antonioasaro/3DChameleon/notes/20250202_094643.jpg

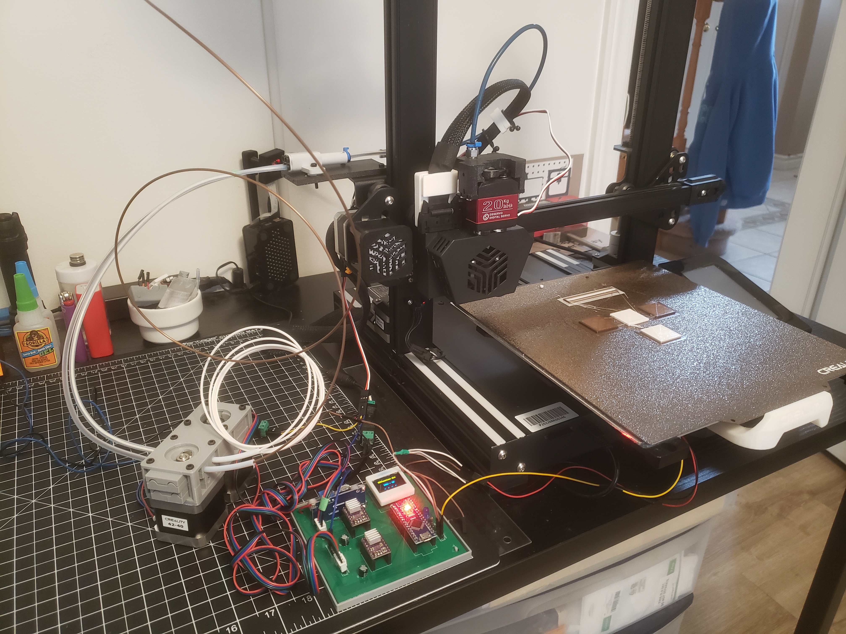
notes/20250202_094643.jpg
