antonioasaro/3DChameleon/arduino_oled_drv8825/arduino_oled_drv8825.step

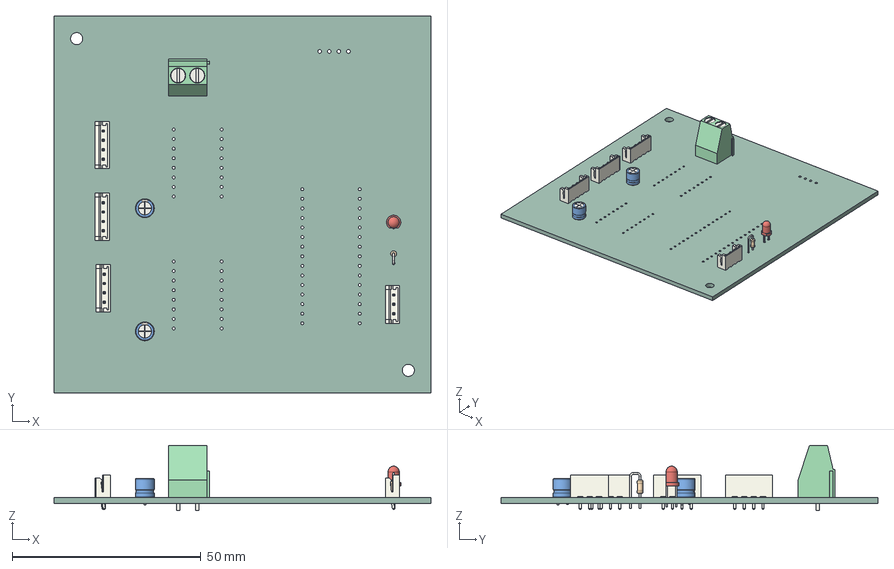
[picture p2: CAD file, 2025-02-16]
arduino_oled_drv8825/arduino_oled_drv8825.step
100.0 x 100.0 x 17.3 mm
JST_B4B_EH_A x 3
JST_B3B_EH_A
TerminalBlock_Phoenix_MKDS_15_2_508_1x02_P508mm_Horizontal
CP_Radial_D50mm_P250mm
LED_D3.0mm
CP_Radial_D50mm_P200mm
R_Axial_DIN0204_L36mm_D16mm_P254mm_Vertical
arduino_oled_drv8825_PCB
