antonioasaro/3DChameleon/STL/Sailfin Blade Holder.stl

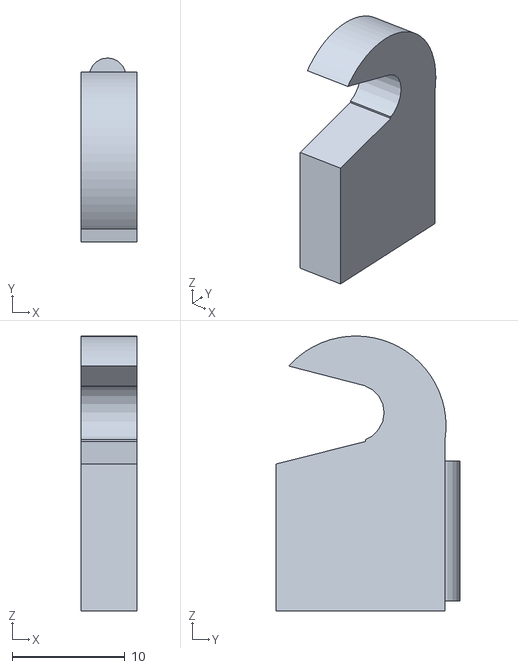
[picture p3: CAD file, 2025-02-17]
STL/Sailfin Blade Holder.stl
5.00 x 16.3 x 24.4
