antonioasaro/3DChameleon/STL/3DClippy_modified_base.stl

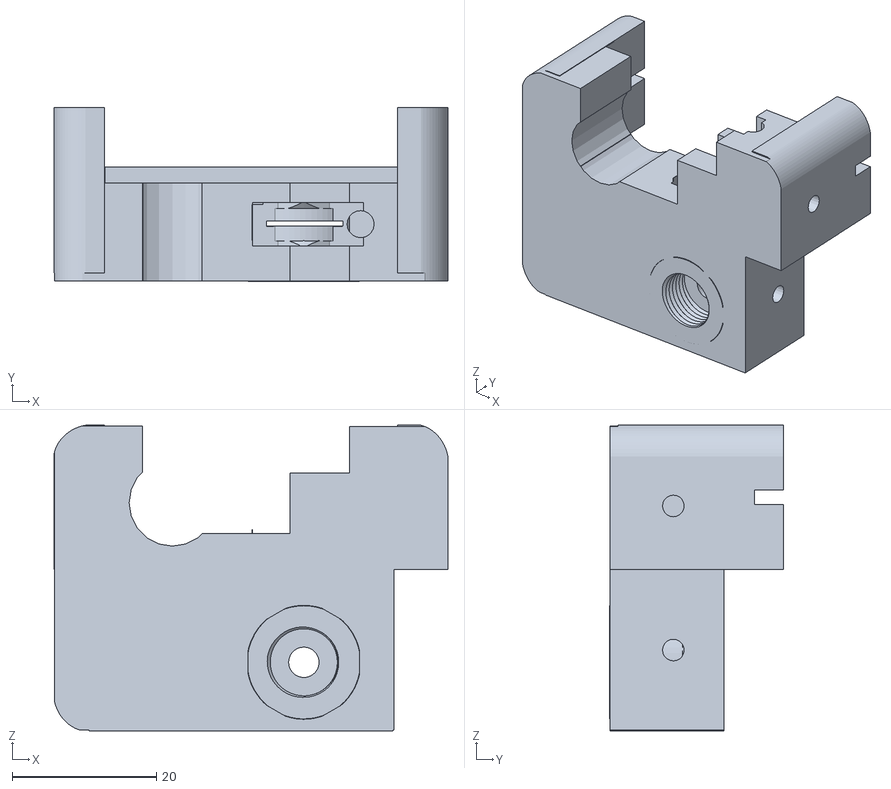
[picture p4: CAD file, 2025-02-17]
STL/3DClippy_modified_base.stl
54.7 x 24.1 x 42.4
