antonioasaro/3DChameleon/STL/3DClippy_stand-top.stl

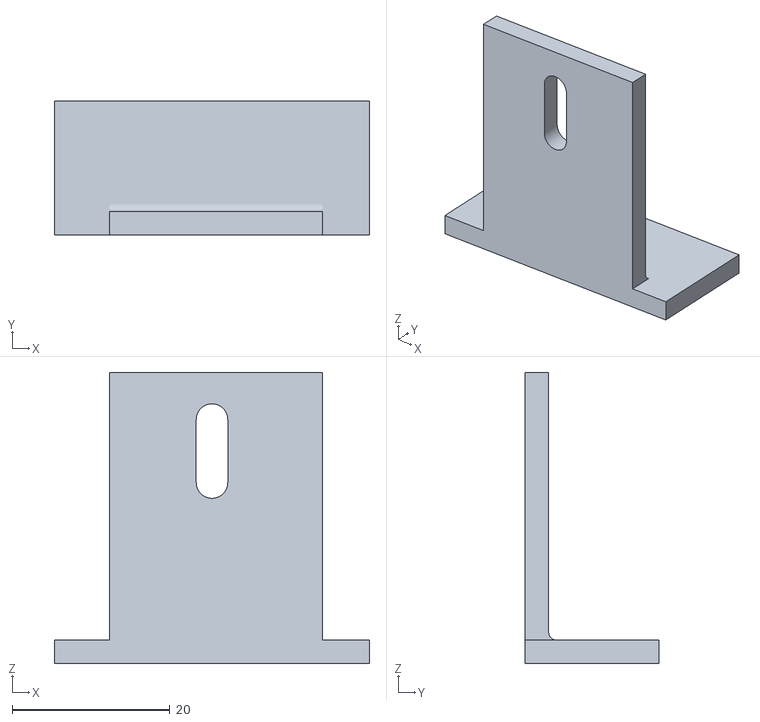
[picture p5: CAD file, 2025-02-17]
STL/3DClippy_stand-top.stl
40.0 x 17.0 x 37.0
