antonioasaro/3DChameleon/STL/3DClippy_stand-base.stl

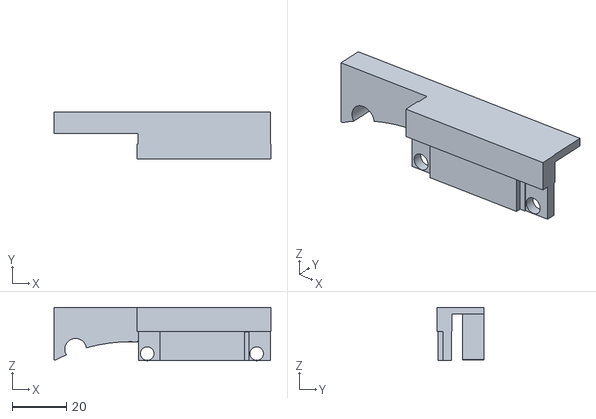
[picture p6: CAD file, 2025-02-17]
STL/3DClippy_stand-base.stl
80.3 x 17.4 x 19.7
