antonioasaro/3DChameleon/arduino_oled_drv8825/arduino_oled_drv8825.kicad_pcb

## KiCad design arduino_oled_drv8825/arduino_oled_drv8825.kicad_pcb (2025-02-16)

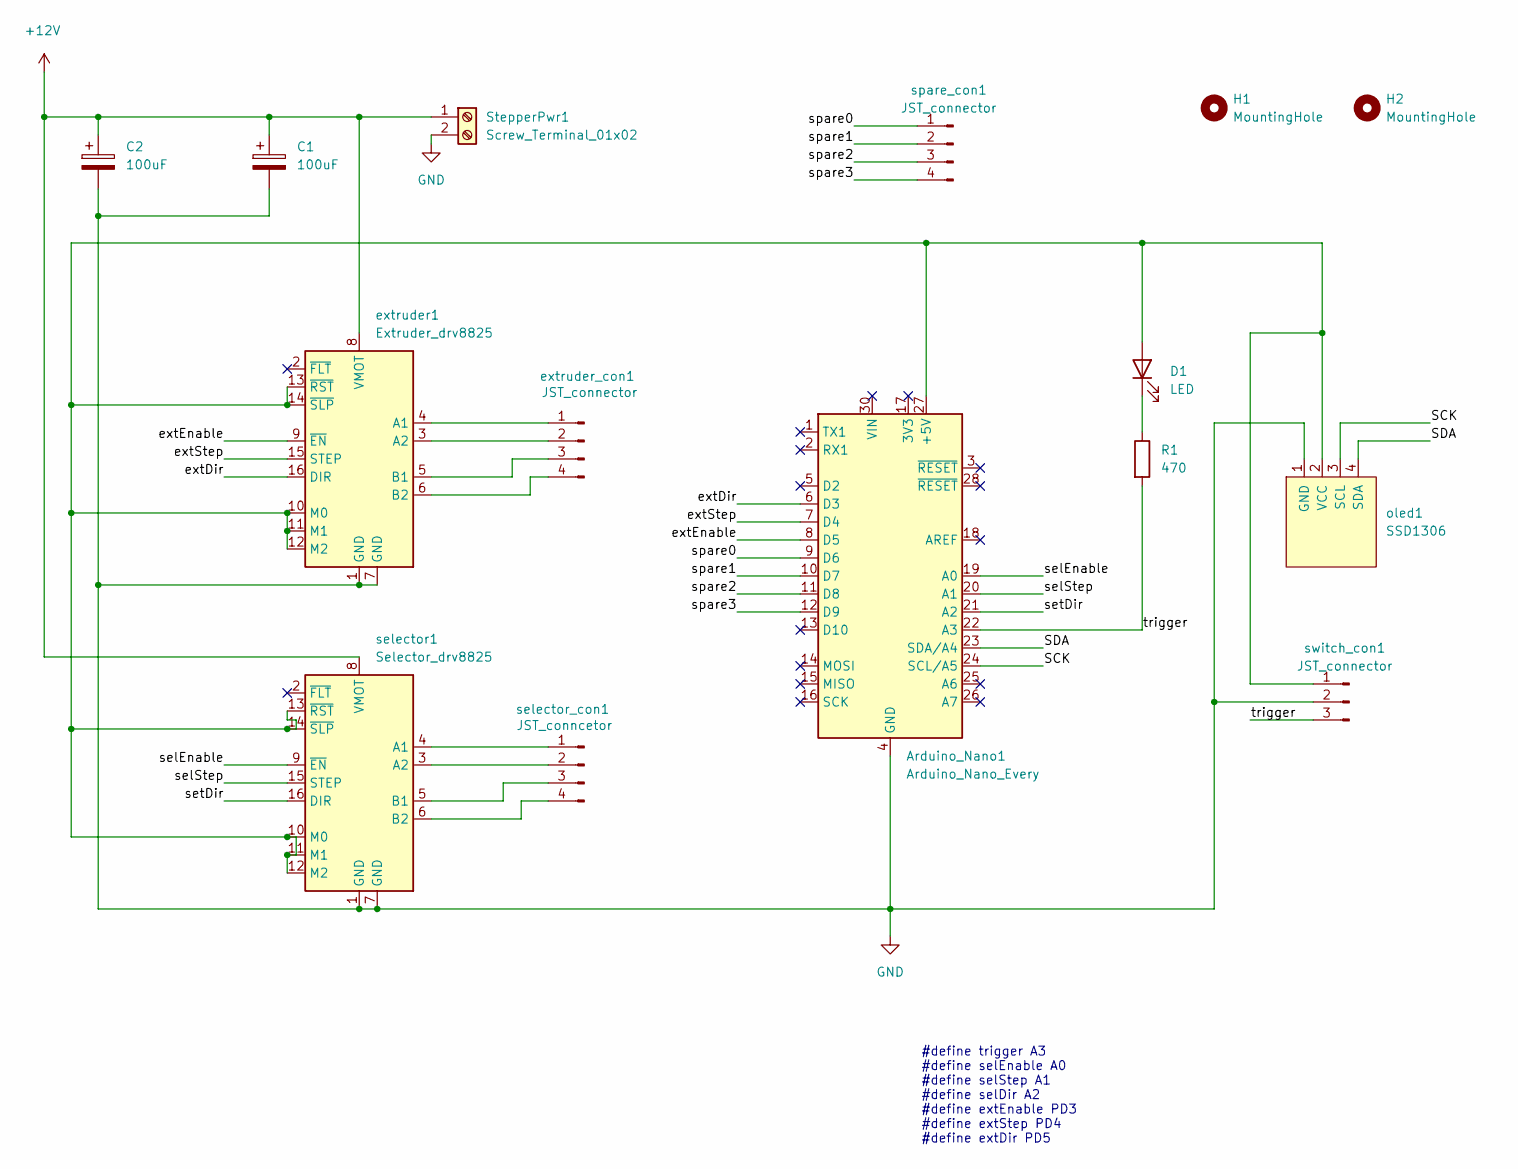
[picture p7: schematic arduino_oled_drv8825.kicad_sch]

Parts:
Arduino_Nano1: Arduino_Nano_Every
C1: 100uF; CP_Radial_D5.0mm_P2.50mm
C2: 100uF; CP_Radial_D5.0mm_P2.00mm
D1: LED; LED_D3.0mm
H1, H2: MountingHole; MountingHole_3.2mm_M3
R1: 470; R_Axial_DIN0204_L3.6mm_D1.6mm_P2.54mm_Vertical
StepperPwr1: Screw_Terminal_01x02; TerminalBlock_Phoenix_MKDS-1,5-2-5.08_1x02_P5.08mm_Horizont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
extruder1: Extruder_drv8825; Pololu_Breakout-16_15.2x20.3mm
extruder_con1: JST_connector; JST_EH_B4B-EH-A_1x04_P2.50mm_Vertical
oled1: SSD1306; 128x64OLED
selector1: Selector_drv8825; Pololu_Breakout-16_15.2x20.3mm
selector_con1: JST_conncetor; JST_EH_B4B-EH-A_1x04_P2.50mm_Vertical
spare_con1: JST_connector; JST_EH_B4B-EH-A_1x04_P2.50mm_Vertical
switch_con1: JST_connector; JST_EH_B3B-EH-A_1x03_P2.50mm_Vertical

Connections:
+12V: C1.1, C2.1, StepperPwr1.1, extruder1.8 (VMOT), selector1.8 (VMOT)
/SCK: Arduino_Nano1.24 (SCL/A5), oled1.3 (SCL)
/SDA: Arduino_Nano1.23 (SDA/A4), oled1.4 (SDA)
/extDir: Arduino_Nano1.6 (D3), extruder1.16 (DIR)
/extEnable: Arduino_Nano1.8 (D5), extruder1.9 (~EN)
/extStep: Arduino_Nano1.7 (D4), extruder1.15 (STEP)
/selEnable: Arduino_Nano1.19 (A0), selector1.9 (~EN)
/selStep: Arduino_Nano1.20 (A1), selector1.15 (STEP)
/setDir: Arduino_Nano1.21 (A2), selector1.16 (DIR)
/spare0: Arduino_Nano1.9 (D6), spare_con1.1
/spare1: Arduino_Nano1.10 (D7), spare_con1.2
/spare2: Arduino_Nano1.11 (D8), spare_con1.3
/spare3: Arduino_Nano1.12 (D9), spare_con1.4
/trigger: Arduino_Nano1.22 (A3), R1.2, switch_con1.3
GND: Arduino_Nano1.4 (GND), Arduino_Nano1.29 (GND), C1.2, C2.2, StepperPwr1.2, extruder1.1 (GND), extruder1.7 (GND), oled1.1 (GND), selector1.1 (GND), selector1.7 (GND), switch_con1.2
unnamed: Arduino_Nano1.27 (+5V), D1.2 (A), extruder1.10 (M0), extruder1.11 (M1), extruder1.12 (M2), extruder1.13 (~RST), extruder1.14 (~SLP), oled1.2 (VCC), selector1.10 (M0), selector1.11 (M1), selector1.12 (M2), selector1.13 (~RST), selector1.14 (~SLP), switch_con1.1
unnamed: D1.1 (K), R1.1
unnamed: extruder1.4 (A1), extruder_con1.1
unnamed: extruder1.3 (A2), extruder_con1.2
unnamed: extruder1.5 (B1), extruder_con1.3
unnamed: extruder1.6 (B2), extruder_con1.4
unnamed: selector1.4 (A1), selector_con1.1
unnamed: selector1.3 (A2), selector_con1.2
unnamed: selector1.5 (B1), selector_con1.3
unnamed: selector1.6 (B2), selector_con1.4

Notes on the sheet:
#define trigger A3 #define selEnable A0 #define selStep A1 #define selDir A2 #define extEnable PD3 #define extStep PD4 #define extDir PD5

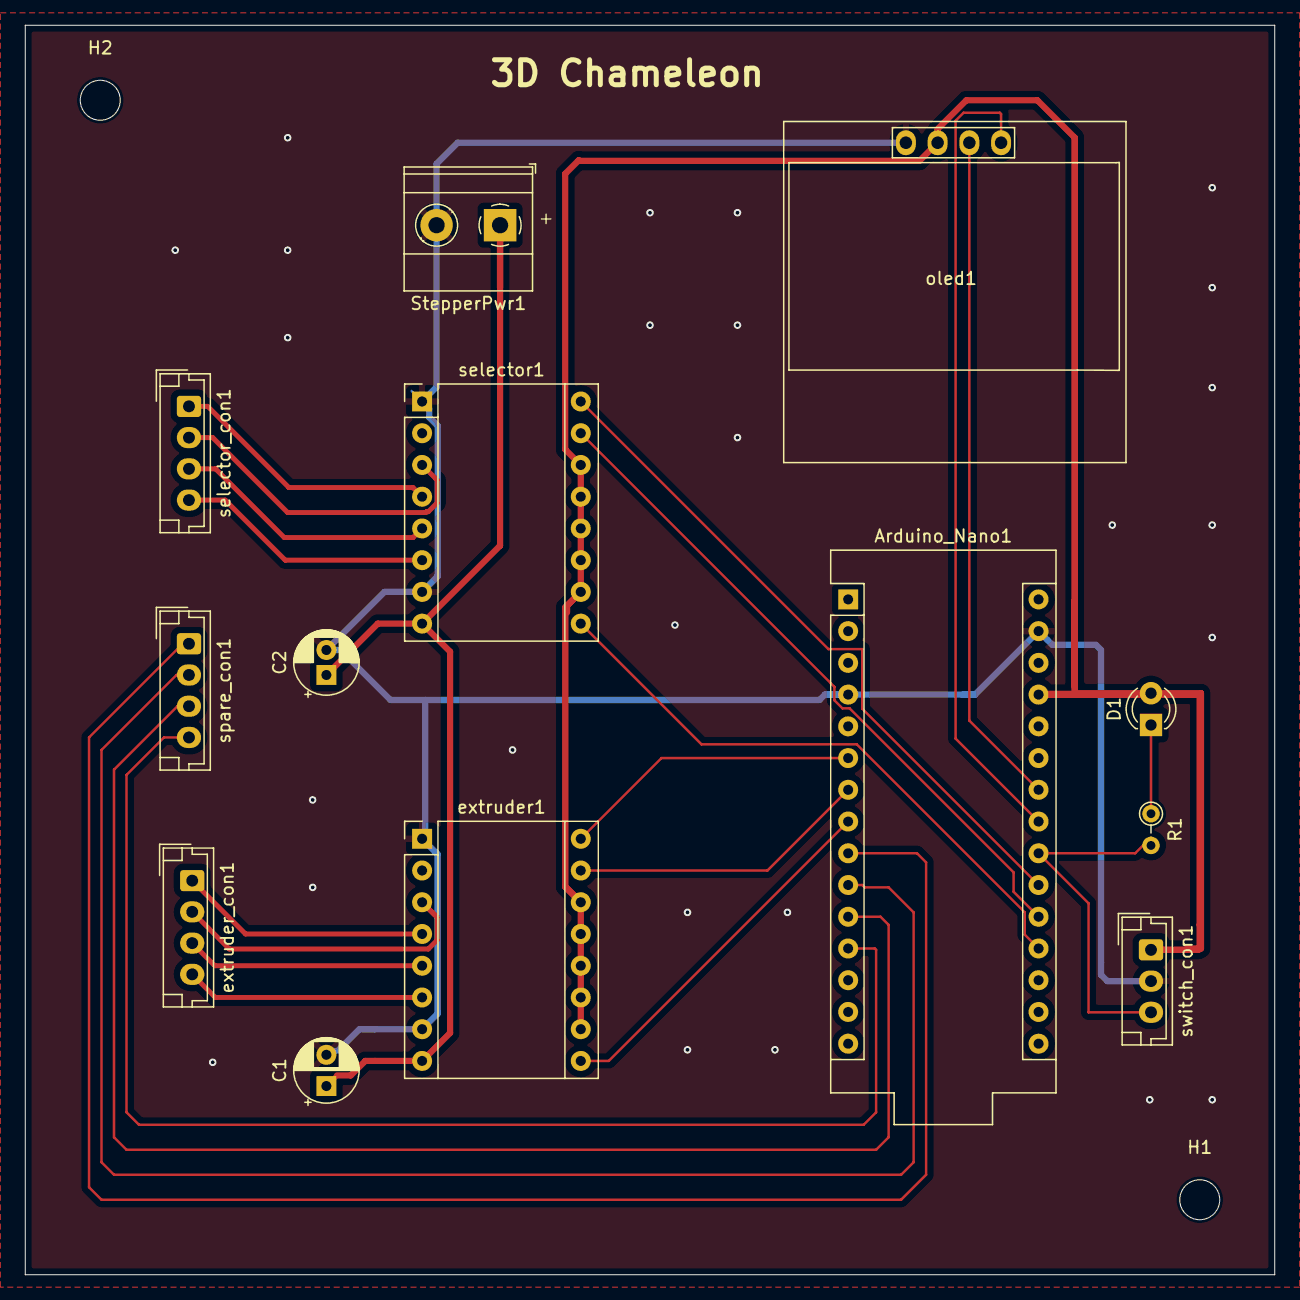
[picture p8: board arduino_oled_drv8825.kicad_pcb from above]

Board: 2 copper layers, 100.0 x 100.0 mm, 15 parts (0 on the bottom side), 25 nets.
