antonioasaro/3DChameleon/notes/CHAMELEON.cfg

[gcode_macro CHAMELEON_START]
gcode:
	G90
	M83
	G92 E0
	G0 X0 Y232 F2000   ; move close to button
	G4 P150            ; wait 150ms
	G0 X0 Y235 F2000   ; press the button 1st time
	G4 P150            ; wait 150ms
	G0 X0 Y232 F2000   ; move close to button
	G4 P150            ; wait 150ms
	G0 X0 Y235 F2000   ; press the button 2st time
	G4 P150            ; wait 150ms
	G0 X0 Y232 F2000   ; move close to button
	G4 P150            ; wait 150ms
	G0 X0 Y235 F2000   ; press the button 3st time
	G4 P150            ; wait 150ms
	G0 X0 Y232 F2000   ; move close to button
	G4 P1000           ; wait 1 second
	G0 X0 Y235 F2000   ; press the button
	G4 P3600           ; wait 7 pulses
	G0 X0 Y232 F2000   ; move away from button
	G4 P2000           ; wait 2 seconds

[gcode_macro CHAMELEON_CUT]
gcode:
	G0 E5 F500
	G0 E-110 F1000
	G0 Y3 F2000
	G4 P5100 ; wait 10 pulses
	G0 Y-3 F2000
	G4 P5000
	G0 E20 F1000
	G0 E-40 F2000
	
[gcode_macro CHAMELEON_EXTRUDE]
gcode:
	G0 Y3 F2000
	G4 P9000
	G0 E25 F1500; <<<--- adjust this E value to tune extruder loading
	G0 Y-3
	G4 P400

[gcode_macro CHAMELEON_EXTRUDE_HOTEND]
gcode:
	G92 E0
	G0 E100 F1000
	G92 E0
	G0 E100 F1000
	G92 E0
	G0 E100 F1000
	G92 E0
	G0 E100 F1000
	G92 E0
	G0 E30 F1000
	G92 E0
	G0 E30 F800 ; <<<<<-----------  EDIT THIS DISTANCE TO FINE TUNE THE FILAMENT LOADING TO STOP BLOBBING OR UNDEREXTRUSION
	G92 E0

[gcode_macro CHAMELEON_RETRACT_HOTEND]
gcode:
	G92 E0
	G0 E-100 F1000
	G92 E0
	G0 E-100 F1000
	G92 E0
	G0 E-100 F1000
	G92 E0
	G0 E-100 F1000
	G92 E0
	G0 E-40 F1000
	G92 E0

[gcode_macro CHAMELEON_RETRACT]
gcode:
	G0 Y3 F2000
	G4 P9000
	G4 P250
	G0 Y-3
	G4 P400

[gcode_macro CHAMELEON_HOMEUNLOAD]
gcode:
	G90                    	; absolute XYZE
	G0 Y232 F2000
	G4 P2000
	G91 					; relative XYZE
	G0 Y3 F2000
	G4 P3100 				; wait 6 pulses
	G0 Y-3 F2000
	G4 P2000


	
