antonioasaro/3DChameleon/SelectorFirmwareMk4/SelectorFirmwareMk4.ino

// November 28, 2024

/* 3DChameleon Mk4.1 Firmware

Copyright 2024 William J. Steele

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
Single Button Press Commands (count pulses of selector)

#1 - 1
#2 - 2
#3 - 3
#4 - 4
#5 - Home and Load
#6 - Unload Last and Home
#7 - Home
#8 - Next Filament
#9 - Random Filament
#10 - Cut
 
*/

#include <SSD1306Ascii.h> //i2C OLED
#include <SSD1306AsciiWire.h> //i2C OLED
#include <SparkFunSX1509.h> // sparkfun i/o expansion board - used for additional filament sensors as well as communications with secondary boards
#include <Wire.h>
#include <SPI.h>
#include <Servo.h>

#define ANTONIO
#define SCREEN_WIDTH 128 // OLED display width, in pixels
#define SCREEN_HEIGHT 64 // OLED display height, in pixels

/**
 * Made with Marlin Bitmap Converter
 * https://marlinfw.org/tools/u8glib/converter.html
 *
 * This bitmap from 128x64 pasted image
 */
#pragma once

const unsigned char bitmap_logo[] PROGMEM = {
  B00000000,B00000000,B00000000,B00000000,B00000000,B00000000,B00000000,B00000000,B00000000,B00000000,B00000000,B00000000,B00000000,B00000000,B00000000,B00000000,
  B00000000,B00000000,B00000000,B00000000,B00000000,B00000000,B00000000,B00000000,B00000000,B00000000,B00000000,B00000000,B00000000,B00000000,B00000000,B00000000,
  B00000000,B00000000,B00000000,B00000000,B00000000,B00000000,B00000000,B00000000,B00000000,B00000000,B00000000,B00000000,B00000000,B00000000,B00000000,B00000000,
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

const int defaultBackoff = 10;

Servo filamentCutter;  // create servo object to control a servo
int cutterPos = 0;    // variable to store the servo position
bool reverseServo = true;

int currentExtruder = -1;
int nextExtruder = 0;
int lastExtruder = -1;
int tempExtruder = -1;

int seenCommand = 0;
int prevCommand = 0;

int loaderMode = 2;  //(0= direct drive, 1=loader/unloader, 2=loader/unloader with press)

long triggerTime = 300;
long pulseTime = (triggerTime / 2);

long distance = 10;

long unloadDistance = stepsPerRev * microSteps * distance;  // this is 10 revs - about 10"
long loadDistance   = unloadDistance * 1.1;           // this is 11 revs - about 11"

int address = 0;
byte value;

long idleCount = 0;
bool logoActive = false;
bool T0Loaded = false;
bool T1Loaded = false;
bool T2Loaded = false;
bool T3Loaded = false;


bool displayEnabled = false;
bool ioEnabled = false;
//int sensorEnabled = 0;

long randomNumber = 0;

void setup()
{

#ifdef ANTONIO
  Serial.begin(115200);
  delay(1000);
  Serial.println("\nSetup ...");
#endif 

  Wire.begin(); //start i2C  
	Wire.setClock(400000L); //set clock

  // set up IO expander
  if (io.begin(SX1509_ADDRESS) == true)
  {
    io.pinMode(SX1509_FILAMENT_0, INPUT_PULLUP);
    io.pinMode(SX1509_FILAMENT_1, INPUT_PULLUP);
    io.pinMode(SX1509_FILAMENT_2, INPUT_PULLUP);
    io.pinMode(SX1509_FILAMENT_3, INPUT_PULLUP);
    io.pinMode(SX1509_OUTPUT, OUTPUT);
    ioEnabled = true;
  }

  // enable OLED display
  oled.begin(&Adafruit128x64, OLED_I2C_ADDRESS);

  // wait for it to start up
  delay(50);
    

  // welcome screen
  oled.setFont(Adafruit5x7);
  oled.clear(); //clear display
	oled.println("");
  oled.println("       Welcome!"); //print a welcome message  
  oled.println("");
  oled.println("    3DChameleon Mk4"); //print a welcome message
  oled.println("");
  oled.println("      Pro - v1.4");
  delay(3000);

  displayText(0, "       Ready!");
  
  seenCommand = 0;

  // Sets the two pins as Outputs
  pinMode(extEnable, OUTPUT);
  pinMode(extStep, OUTPUT);
  pinMode(extDir, OUTPUT);

  pinMode(selEnable, OUTPUT);
  pinMode(selStep, OUTPUT);
  pinMode(selDir, OUTPUT);

  // set up the button
  pinMode(trigger, INPUT_PULLUP);  // selector

  // a little override here... we're using the two inputs as I2C instead
  pinMode(s_limit, OUTPUT);    
  pinMode(filament, OUTPUT); 

  // lock the selector by energizing it
  digitalWrite(selEnable, HIGH);

  // make sure filament isn't blocked by gillotine
  connectGillotine();
 #ifdef ANTONIO
  openServo();
 #else 
  cutFilament();
 #endif 
  disconnectGillotine();
  
  prevCommand = 0;

#ifdef ANTONIO
  Serial.println("Done.");
#endif

}

int lastLoop = 0;

void loop()
{
  static uint32_t lastTime = 0;

  seenCommand = 0;
  idleCount++;

  // process button press
  if (digitalRead(trigger) == 0)
  {
    idleCount = 0;
    logoActive = false;
    unsigned long nextPulse;
    unsigned long pulseCount = 0;
    unsigned long commandCount = 0;

    // keep counting (and pulsing) until button is released
    while (digitalRead(trigger) == 0)
    {
      if(pulseCount<pulseTime)
      {
        pulseCount++;
        displayCommand(pulseCount);
        if(pulseCount>1) vibrateMotor();
      }
      delay(400);  // each pulse is 400+ milliseconds apart 
    }
    processCommand(pulseCount); // ok... execute whatever command was caught (by pulse count)
    pulseCount = 0;
  }

  // updates IO block, duh!  No really, grabs the state of the sparkfun gpio expansion
  updateIOBlock();

  // each loop adds 50ms delay, so that gets added AFTER the command is processed before the next one can start
  delay(50);
}

// read the sparkfun SX1509 io
void updateIOBlock()
{
    if(ioEnabled)
    {
      T0Loaded = io.digitalRead(SX1509_FILAMENT_0);
      T1Loaded = io.digitalRead(SX1509_FILAMENT_1);
      T2Loaded = io.digitalRead(SX1509_FILAMENT_2);
      T3Loaded = io.digitalRead(SX1509_FILAMENT_3);
    }
}

// display command for each button pulse
void displayCommand(long commandCount)
{

  switch(commandCount)
  {
  case 2:
    displayText(25, "    Switch to T0");
    break;
  case 3:
    displayText(25, "    Switch to T1");
    break;
  case 4:
    displayText(25, "    Switch to T2");
    break;
  case 5:
    displayText(25, "    Switch to T3");
    break;
  case 6:
    displayText(25, "    Home/Load T0");
    break;
  case 7:
    displayText(28, "    Unload/Home");
    break;
  case 8:
    displayText(50, "        Home");
    break;  
  case 9:
    displayText(50, "        Next");
    break;
  case 10:
    displayText(40, "       Random");
    break;
#ifdef ANTONIO   
  case 11:
    displayText(50, "       Cut ");
    break;  
#endif
  default:
    displayText(30, "     No Command");
    break;
  }
}

// execute the pulse count command
void processCommand(long commandCount)
{

  // select case for commands
  switch (commandCount)
  {
  case 2: // unload current, switch to #0, load
    displayText(30, "     T0 Selected");
    currentExtruder = 0;
    processMoves();
    displayText(35, "      Idle - T0");
    break;

  case 3: // unload current, switch to #1, load
    displayText(30, "     T1 Selected");
    currentExtruder = 1;
    processMoves();
    displayText(35, "      Idle - T1");
    break;

  case 4: // unload current, switch to #3, load
    displayText(30, "     T2 Selected");
    currentExtruder = 2;
    processMoves();
    displayText(35, "      Idle - T2");
    break;

  case 5: // unload current, switch to #4, load
    displayText(30, "     T3 Selected");
    currentExtruder = 3;
    processMoves();
    displayText(35, "      Idle - T3");
    break;

  case 6: //home and reload #1
    displayText(40, "      Homing...");
    homeSelector();
    displayText(15, "   Press to Load T0");
    gotoExtruder(0, 0);
    if(loaderMode>0)rotateExtruder(clockwise, loadDistance);
    if(loaderMode>0)gotoExtruder(0, 1);
    currentExtruder = 0;
    lastExtruder = 0;
    displayText(35, "      Idle - T0");
    break;
    
  case 7: // unload current and rehome selector
    displayText(30, "     Cutting...");
    connectGillotine();
    cutFilament();
    switch(lastExtruder)
    {
      case 0:
        displayText(10, "  Press to Unload T0");
        break;
      case 1:
        displayText(10, "  Press to Unload T1");
        break;
      case 2:
        displayText(10, "  Press to Unload T2");
        break;
      case 3:
        displayText(10, "  Press to Unload T3");
        break;
    } 
    if(loaderMode>0)gotoExtruder((lastExtruder==3?2:lastExtruder+1),lastExtruder);
    if(lastExtruder<2)
    {
      if(loaderMode>0)rotateExtruder(counterclockwise, unloadDistance);
    }
    else
    {
      if(loaderMode>0)rotateExtruder(clockwise, unloadDistance);
    }
    disconnectGillotine();
    displayText(50, "        Idle");
    break;

  case 8:  
    displayText(40, "     Homing...");
    homeSelector();
    displayText(50, "        Idle");
    break;

  case 9: // move to next available filament
    displayText(30, "     Cutting...");
    connectGillotine();
    cutFilament();
    displayText(30, "     Next Tool");
    currentExtruder++;
    if(currentExtruder==4)currentExtruder=0;
    processMoves();
    displayText(35, "        Idle");
    break;

  case 10: // move to a random filament
    displayText(30, "     Cutting...");
    connectGillotine();
    cutFilament();
    displayText(30, "    Random Tool");

    // select a random number
    randomNumber = random(0,2) + 1;

    // skip ahead that many tools
    for(long i=0; i<randomNumber; i++)
    {
      currentExtruder++;
      if(currentExtruder==4)currentExtruder=0;
    }
    processMoves();
    displayText(50, "        Idle");
    break;
#ifdef ANTONIO  
  case 11: // cut filament
    displayText(30, "     Cutting...");
    connectGillotine();
    cutServo();
    cutServo();
    disconnectGillotine();
    displayText(50, "        Idle");
    break;
 #endif  
    
  default:
    displayText(47, "       Clear");
    delay(200);

    displayText(50, "        Idle");
    break;
  }
}

// just the routine to update the OLED
void displayText(int offset, String str)
{

  //if(displayEnabled){
    oled.clear();
    oled.println("");
    oled.println("   3DChameleon Mk4"); //print a welcome message
    oled.println("");
    oled.println("");
    oled.println(str);
    oled.println("");
    oled.println("");
    if(ioEnabled)
    {
      oled.print("     ");
      if(T0Loaded)
      {
        oled.print("0  ");
      }
      else
      {
        oled.print("+  ");
      }
      if(T1Loaded)
      {
        oled.print("1  ");
      }
      else
      {
        oled.print("+  ");
      }
      if(T2Loaded)
      {
        oled.print("2  ");
      }
      else
      {
        oled.print("+  ");
      }
      if(T3Loaded)
      {
        oled.println("3");
      }
      else
      {
        oled.println("+");
      }
    }
    else
    {
      oled.println("     -  -  -  -");
    }
  //  }
}

// real work is here
void processMoves()
{

  // make sure we have a real extruder selected
  if(lastExtruder>-1)
  {

    // if so, we need to cut the filament
    displayText(30, "     Cutting...");
    connectGillotine();
    cutFilament();

    // ok... then wait for the 2nd button press to unload it
    switch(lastExtruder)
    {
      case 0:
        displayText(10, "  Press to Unload T0");
        break;
      case 1:
        displayText(10, "  Press to Unload T1");
        break;
      case 2:
        displayText(10, "  Press to Unload T2");
        break;
      case 3:
        displayText(10, "  Press to Unload T3");
        break;
    } 

    // roll over to first if on last
    if( loaderMode>0 ) gotoExtruder( ( lastExtruder==3 ? 2 : (lastExtruder+1)), lastExtruder);

    // this determines which direction to move the motor, 0-1 : counterclockwise, 2-3 : clockwise
    if(lastExtruder<2)
    {
      if(loaderMode>0)rotateExtruder(counterclockwise, unloadDistance);
    }
    else
    {
      if(loaderMode>0)rotateExtruder(clockwise, unloadDistance);
    }
  }
  else
  {
    lastExtruder = 0;
  }
  disconnectGillotine();
  
  // tell it to actually execute that command now
  gotoExtruder(lastExtruder, currentExtruder);

  // ok... filament unloaded, time to load the new... so tell the user
  switch(currentExtruder)
  {
    case 0:
      displayText(15, "   Press to Load T0");
      break;
    case 1:
      displayText(15, "   Press to Load T1");
      break;
    case 2:
      displayText(15, "   Press to Load T2");
      break;
    case 3:
      displayText(15, "   Press to Load T3");
      break;
  }

  // same (but inversed) logic for motor direction
  if(currentExtruder<2)
  {
    if(loaderMode>0)rotateExtruder(clockwise, loadDistance);
  }
  else
  {
    if(loaderMode>0)rotateExtruder(counterclockwise, loadDistance);
  }

  // if we're loading, then load it now
  if(loaderMode>0)gotoExtruder(currentExtruder, (currentExtruder==3?2:currentExtruder+1));

  // everybody remember where we parked!
  lastExtruder = currentExtruder;
}


// this function simply moves from the currentCog to the targetCog is the best way
void gotoExtruder(int currentCog, int targetCog)
{
 
  int newCog = targetCog - currentCog;

  // ok... which way
  int newDirection = counterclockwise;
  if(newCog<0)
  {
    // we need to move the other way
    newDirection = clockwise;

    //and since we know we went too far... let's go the other way in steps as well
    newCog = currentCog - targetCog;
  }

  // if we're already on the current cog, then do nothing
  if(newCog > 0)
  {    
    // advance tool targetCog times
    for(int i=0; i<newCog; i++)
    {
      rotateSelector(newDirection, (stepsPerRev / 4) * microSteps);
    }
  }
}

// move the extruder motor in a specific direction for a specific distance (unless it's a "until button is not pressed")
void rotateExtruder(bool direction, long moveDistance)
{
  // note to bill:  make this acecelerate so it's very fast!!!
  
  digitalWrite(extEnable, LOW);  // lock the motor
  digitalWrite(extDir, direction); // Enables the motor to move in a particular direction
  const int fastSpeed = speedDelay/2; // double time

  // this is depricated right now... might bring it back in the future
  if(loaderMode==1)
  {

    // Makes 50 pulses for making one full cycle rotation
    for (long x = 0; x < (moveDistance-1); x++)
    {
      // this is how we pulse the motor to get it to step
      digitalWrite(extStep, HIGH);
      delayMicroseconds(fastSpeed);
      digitalWrite(extStep, LOW);
      delayMicroseconds(fastSpeed);
    }

  }

  if(loaderMode==2)
  {

   // keep waiting until button is pressed
   while (digitalRead(trigger) != 0)
    {
      delay(50);
    }
    
    // Move while button is pressed
    while (digitalRead(trigger) == 0)
    {

      // this is how we pulse the motor to get it to step
      digitalWrite(extStep, HIGH);
      delayMicroseconds(fastSpeed);
      digitalWrite(extStep, LOW);
      delayMicroseconds(fastSpeed);
    }
  }
  // ok, done pressing button, so make sure we're not energized (high is no, low is yes)
  digitalWrite(extEnable, HIGH);
}

// similar to extruder, but only stepping 50 (of 200) at a time
void rotateSelector(bool direction, int moveDistance)
{

  // while we are at it... can we make this faster using the magic you invented above?
  
  digitalWrite(selEnable, LOW); // lock the selector
  digitalWrite(selDir, direction); // Enables the motor to move in a particular direction

    // Makes 50 pulses for making one full cycle rotation
    for (int x = 0; x < (moveDistance-1); x++)
    {
      digitalWrite(selStep, HIGH);
      delayMicroseconds(speedDelay);
      digitalWrite(selStep, LOW);
      delayMicroseconds(speedDelay);
    }
}

// this cycles the servo between two positions
#ifdef ANTONIO
void cutFilament() {
  return;
}
void openServo() {
  digitalWrite(selEnable, LOW); // disable stepper so we have power!
  delay(250);
  filamentCutter.write(RELPOS);
  delay(250);
  digitalWrite(selEnable, HIGH);
}
void cutServo() {
  digitalWrite(selEnable, LOW); // disable stepper so we have power!
  delay(250);
  closeGillotine();
  openGillotine();
  delay(250);
  digitalWrite(selEnable, HIGH);
}
#else
void cutFilament() {
  digitalWrite(selEnable, LOW); // disable stepper so we have power!
  if(reverseServo==false)
  {
    openGillotine();
    closeGillotine();
  }
  else
  {
    closeGillotine();
    openGillotine();
  }
  digitalWrite(selEnable, HIGH);
}
#endif

// enable the servo
void connectGillotine()
{
#ifdef ANTONIO
  filamentCutter.attach(SERVOPIN);
#else  
  filamentCutter.attach(11);
#endif
}

// disable the servo - so it doesn't chatter when not in use
void disconnectGillotine()
{
  filamentCutter.detach();
}

// cycle servo from 135 and 180
void openGillotine()
{
#ifdef ANTONIO 
    for (int pos = CUTPOS; pos <= RELPOS; pos += ROTDIR) {
      filamentCutter.write(pos);
      delay(15);
    } 
    delay(50);
#else
    for (int pos = 135; pos <= 180; pos += 1) { // goes from 0 degrees to 180 degrees
    // in steps of 1 degree
    filamentCutter.write(pos);              // tell servo to go to position in variable 'pos'
    delayMicroseconds(25000);                       // waits 15ms for the servo to reach the position
  }
  //filamentCutter.write(3.5);       // tell servo to go to position in variable 'pos'
  delay(50);  
#endif                       // waits 15ms for the servo to reach the position
}

// reverse cycle servo from 180 back to 135
void closeGillotine()
{
#ifdef ANTONIO
   filamentCutter.write(CUTPOS);
   delay(250);
#else  
  for (int pos = 180; pos >= 135; pos -= 1) { // goes from 180 degrees to 0 degrees
    filamentCutter.write(pos);              // tell servo to go to position in variable 'pos'
    delayMicroseconds(25000);                       // waits 15ms for the servo to reach the position
  }
  delay(50);                       // waits 15ms for the servo to reach the position
#endif  
}

// rotate the selector clockwise too far from 4, so it'll grind on the bump stop
void homeSelector()
{
  // rotate counter clockwise to hard stop
  rotateSelector(clockwise, stepsPerRev * microSteps);

  // move just slightly to extruder 1 (this backs off a little from the hard stop)
  rotateSelector(counterclockwise, defaultBackoff * microSteps);

 currentExtruder = 0;
 lastExtruder = -2;

}

// buzz buzz buzz
void vibrateMotor()
{
  // oscillate selector 1 time
  rotateSelector(clockwise, 2 * 16);
  rotateSelector(!clockwise, 2 * 16);
}
