antonioasaro/3DChameleon/(commit log)

2025-02-16 Initial version
    [arduino_oled_drv8825.kicad_pcb, arduino_oled_drv8825.kicad_sch, arduino_oled_drv8825.step]
2025-02-17 Included cfg files with kilpper macros
    [CHAMELEON.cfg]
2025-02-17 Added STL files
    [3DClippy_modified_base.stl, 3DClippy_stand-base.stl, 3DClippy_stand-top.stl]
2025-02-17 More STL files
    [Sailfin Blade Holder.stl]
2025-02-23 filament swapping test
